Markus-Fitz/Simple_amp_discrete_Rev-A/images/render_PSU.PNG

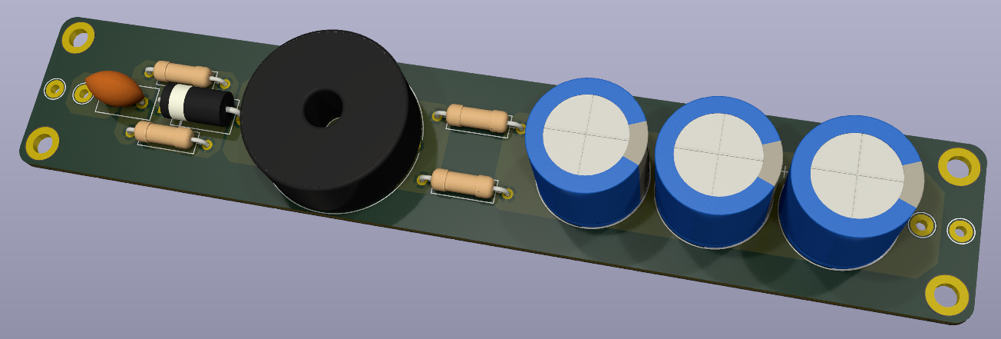
images/render_PSU.PNG
