Markus-Fitz/Simple_amp_discrete_Rev-A/images/rendering.PNG

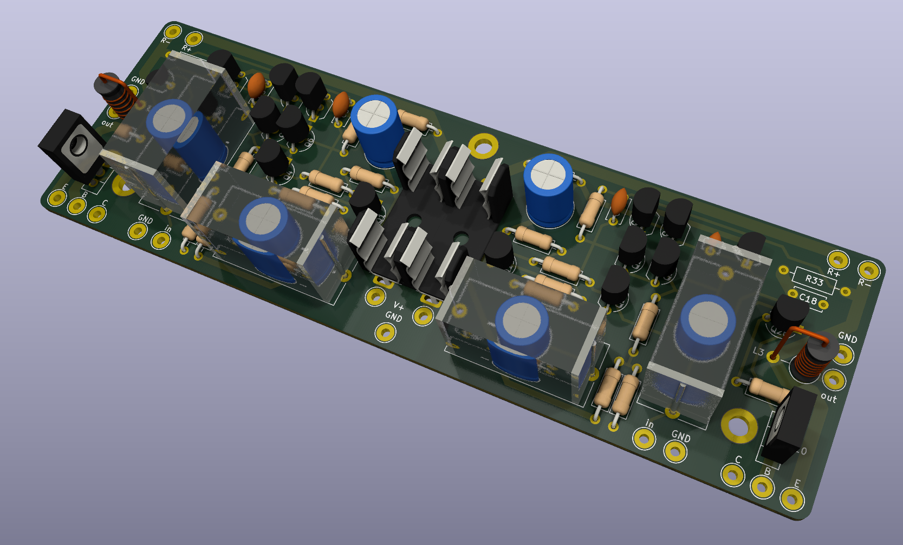
images/rendering.PNG
