Markus-Fitz/Simple_amp_discrete_Rev-A/images/bode_plot.PNG

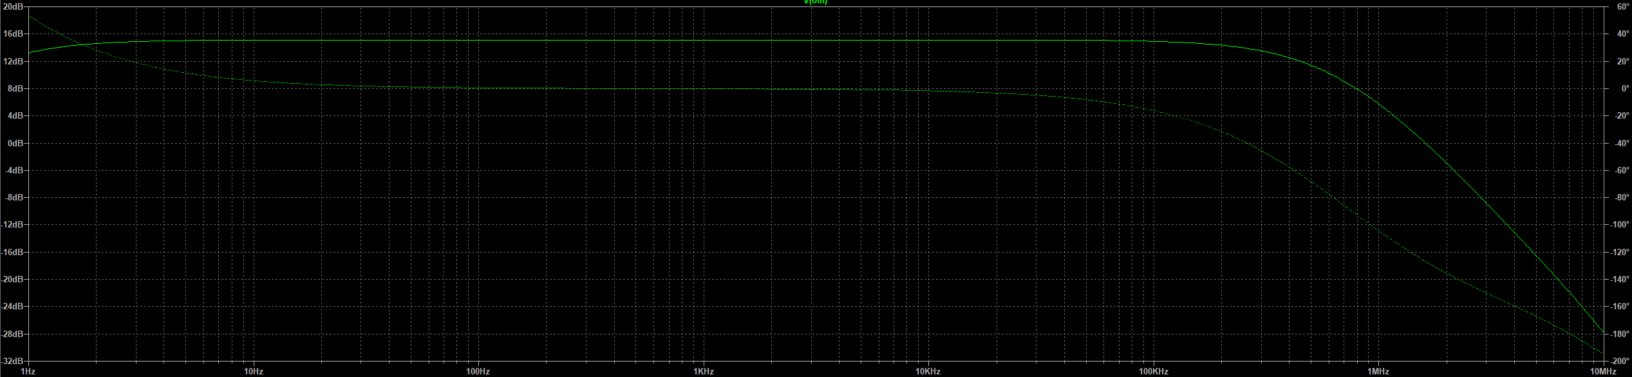
images/bode_plot.PNG
