Markus-Fitz/Simple_amp_discrete_Rev-A/images/bode_plot_fully_transistorized.PNG

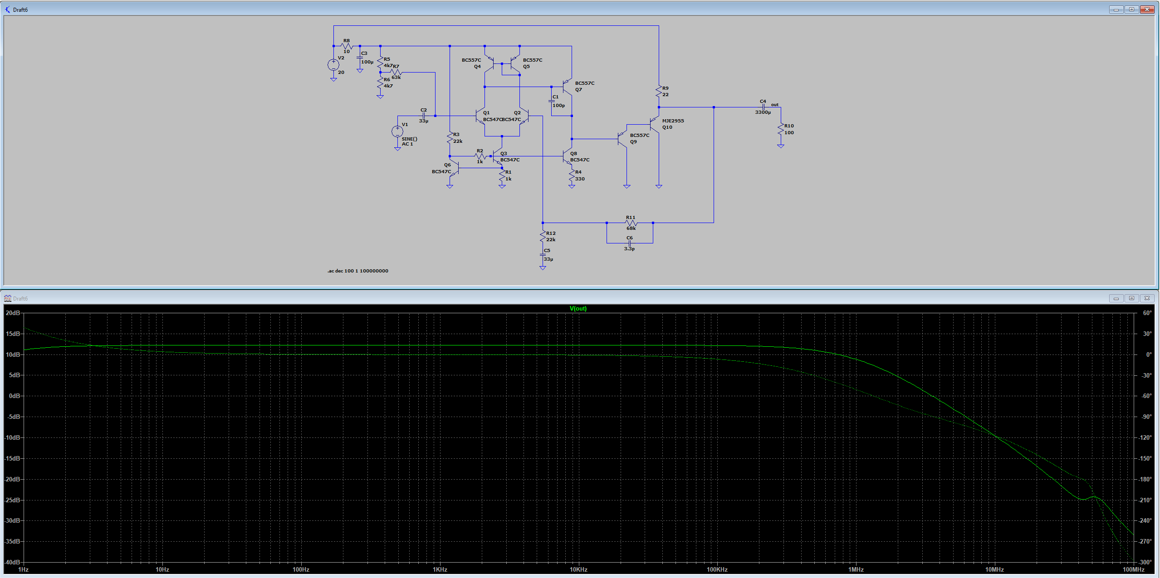
images/bode_plot_fully_transistorized.PNG
