Markus-Fitz/Simple_amp_discrete_Rev-A/images/PCB.PNG

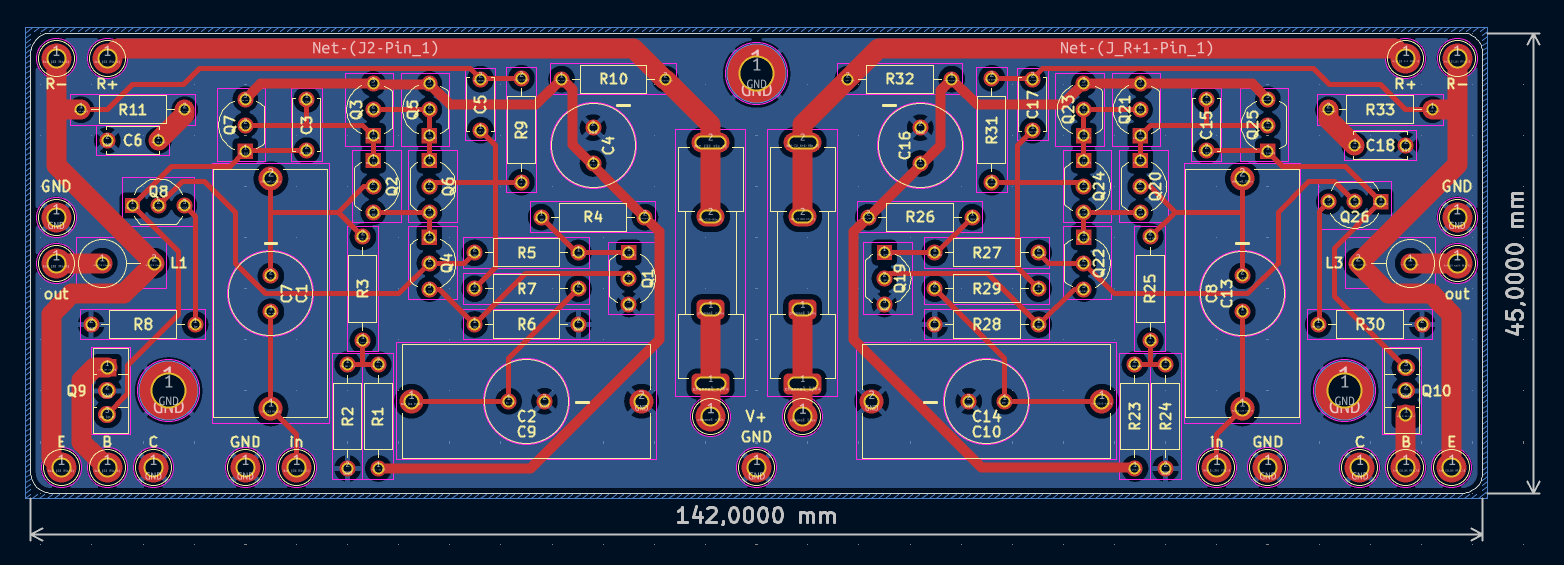
images/PCB.PNG
