Markus-Fitz/Simple_amp_discrete_Rev-A/images/PCB_back.PNG

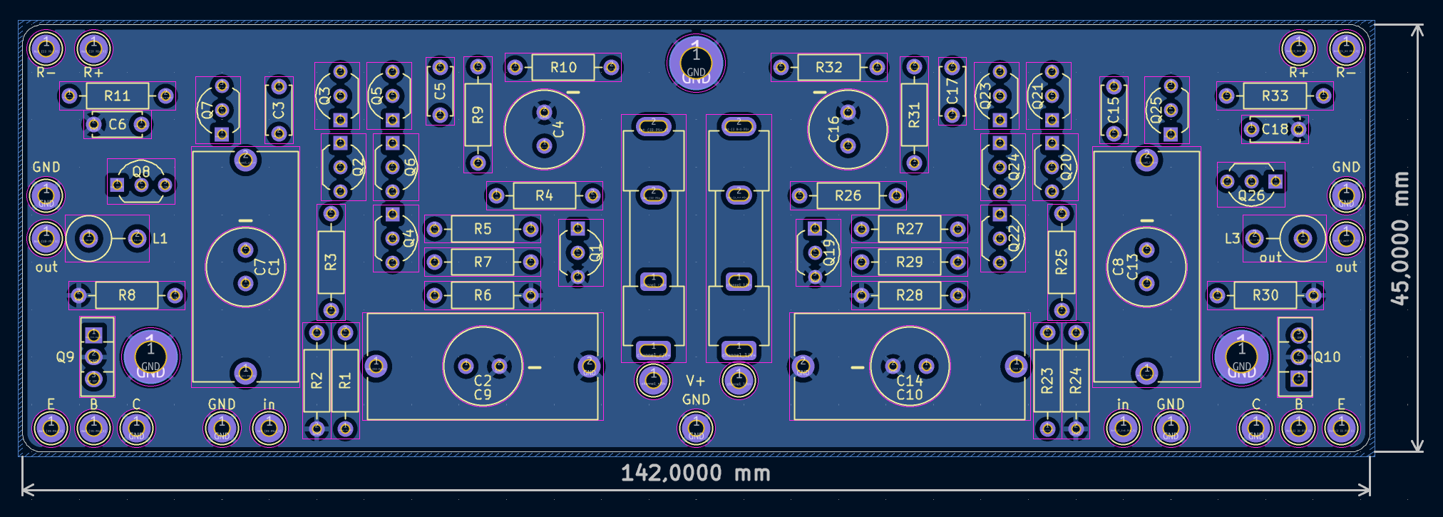
images/PCB_back.PNG
