Markus-Fitz/Simple_amp_discrete_Rev-A/images/PCB_delay-board.png

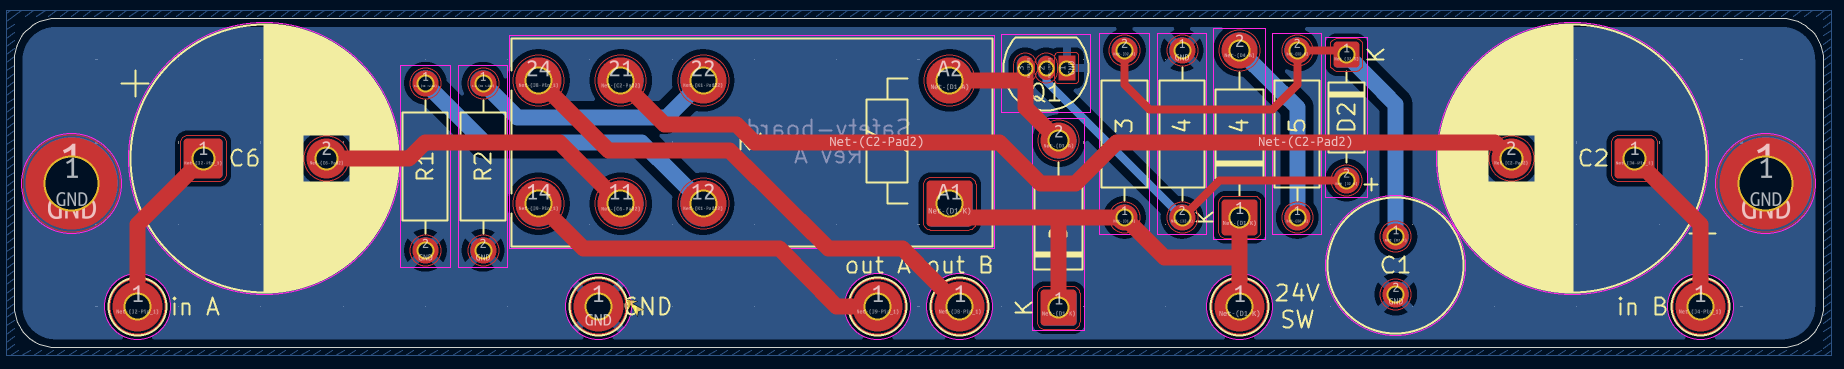
images/PCB_delay-board.png
