Markus-Fitz/Simple_amp_discrete_Rev-A/images/PCB_front.PNG

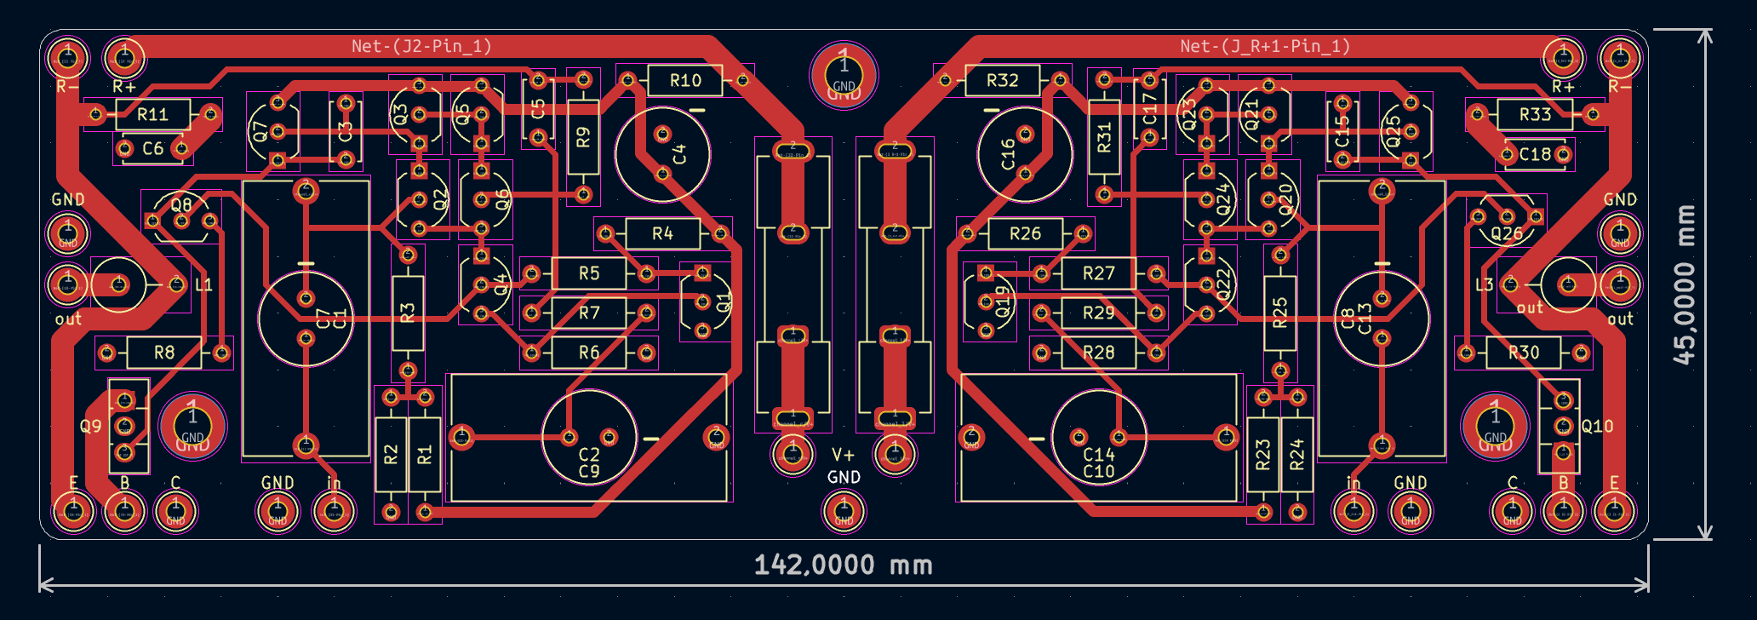
images/PCB_front.PNG
