Markus-Fitz/Simple_amp_discrete_Rev-A/images/PCB_PSU_front.PNG

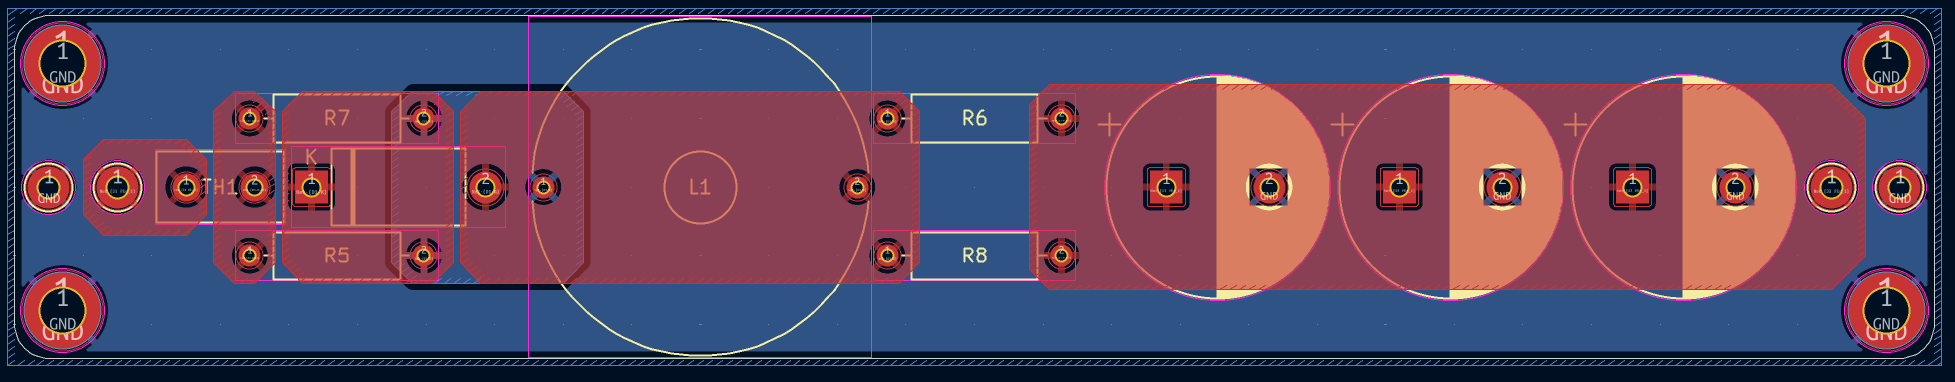
images/PCB_PSU_front.PNG
