Markus-Fitz/Simple_amp_discrete_Rev-A/images/rendering_delay-board.png

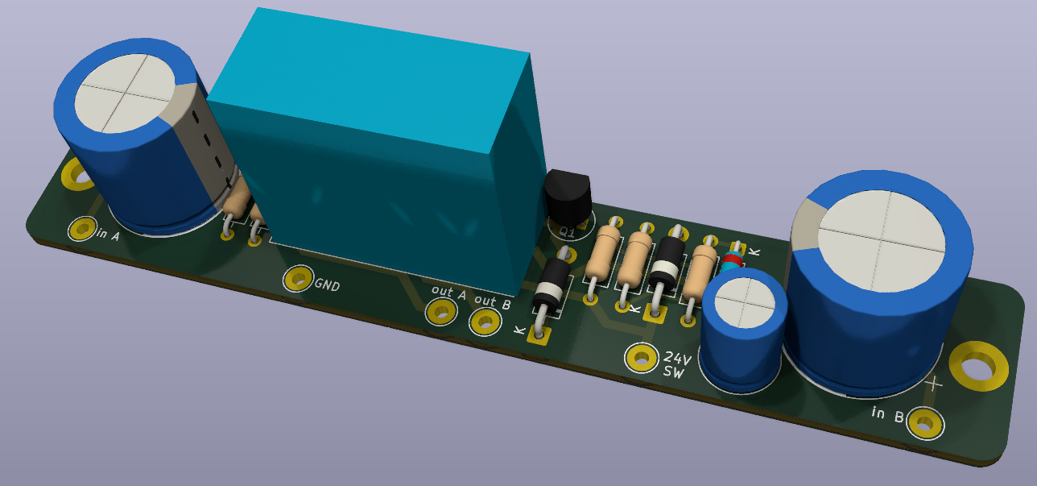
images/rendering_delay-board.png
