Markus-Fitz/Simple_amp_discrete_Rev-A/images/schematic.PNG

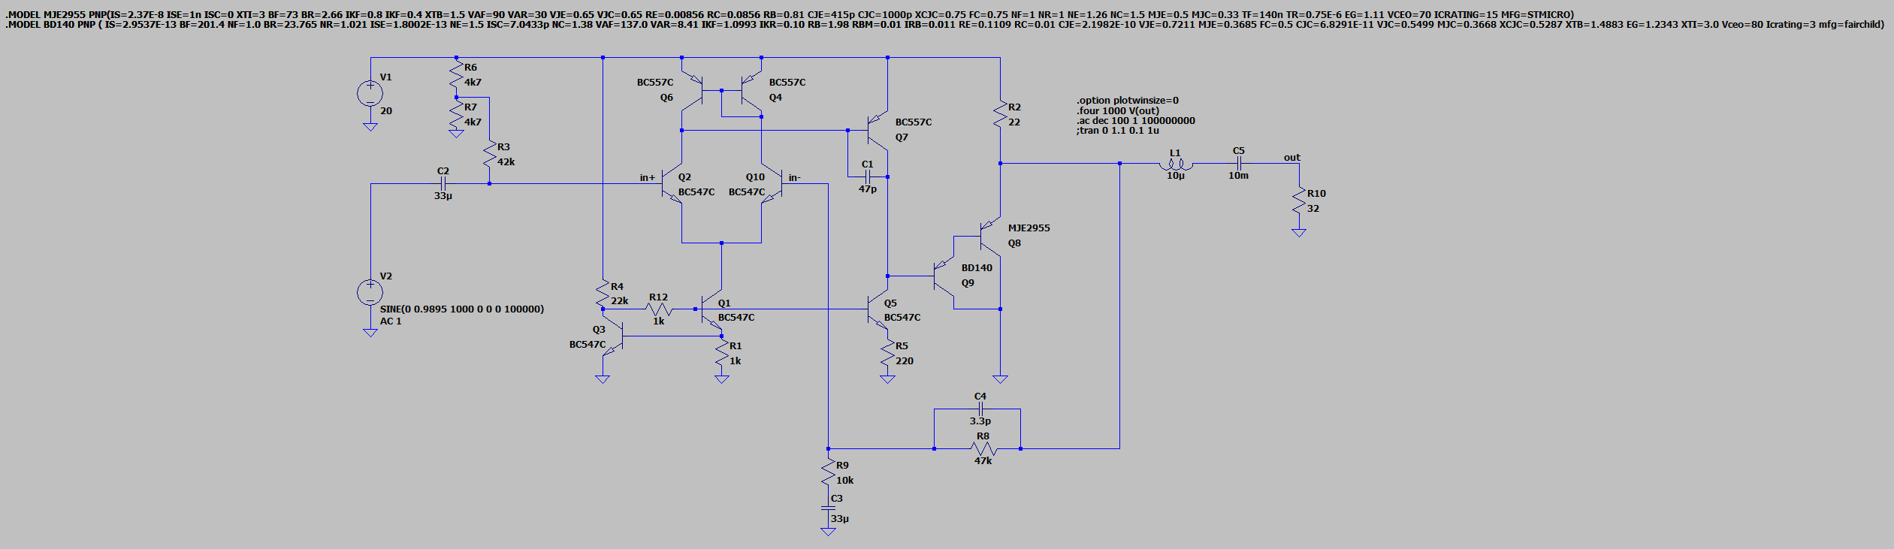
images/schematic.PNG
