Markus-Fitz/Simple_amp_discrete_Rev-A/images/schematic_delay-board.png

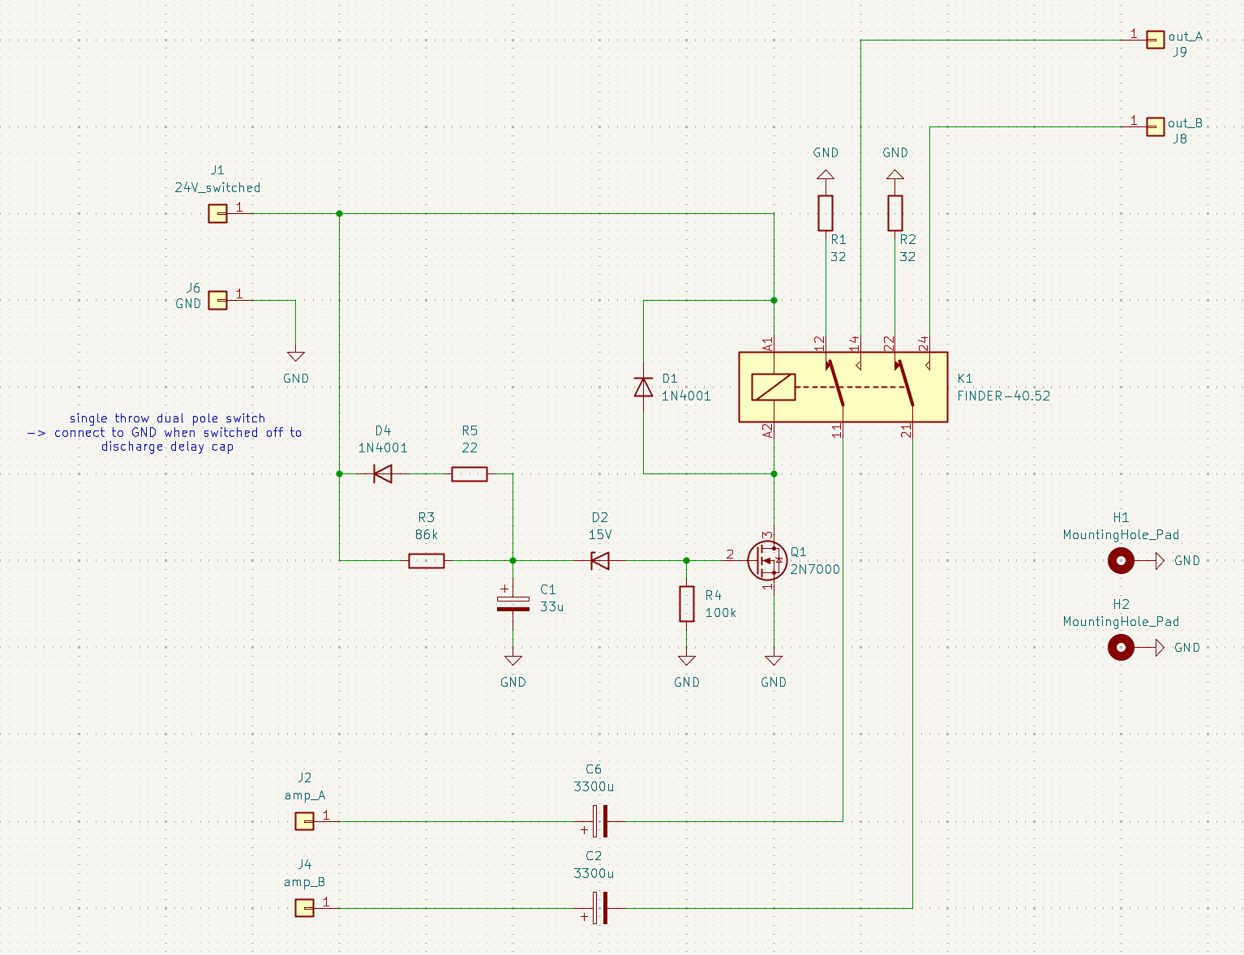
images/schematic_delay-board.png
