Markus-Fitz/Simple_amp_discrete_Rev-A/images/Schematic_high-level.PNG

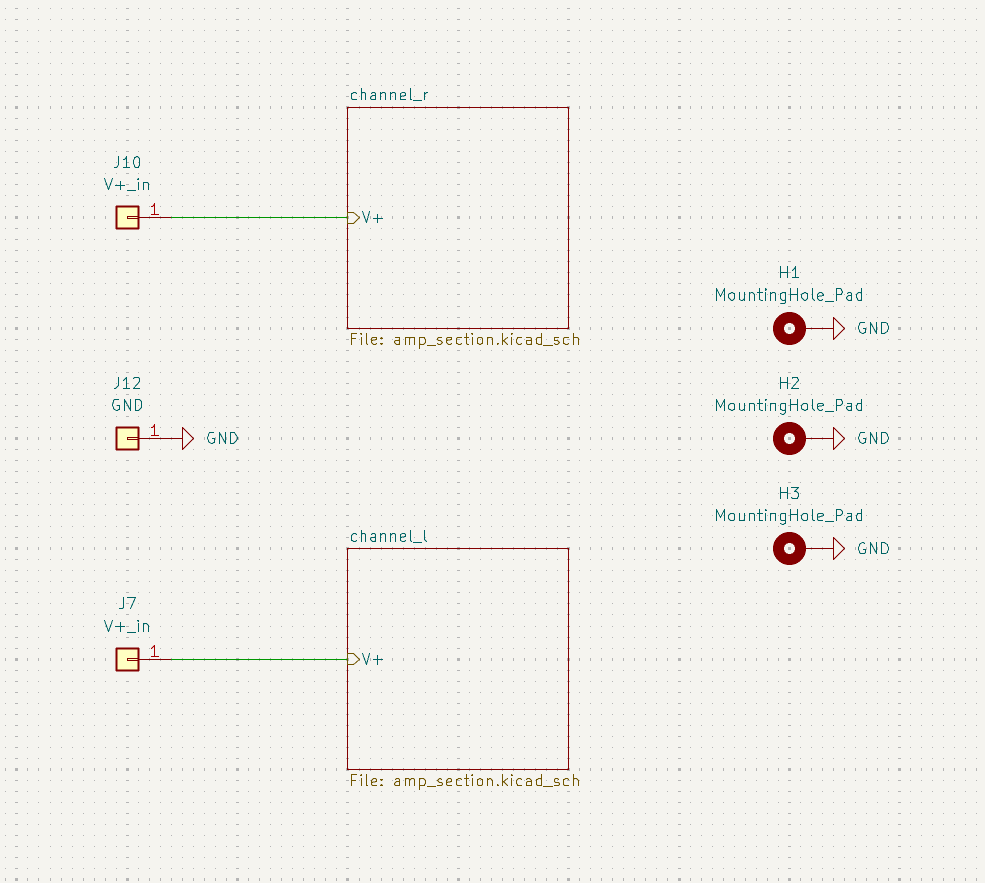
images/Schematic_high-level.PNG
