Markus-Fitz/Simple_amp_discrete_Rev-A/images/schematic_PSU.PNG

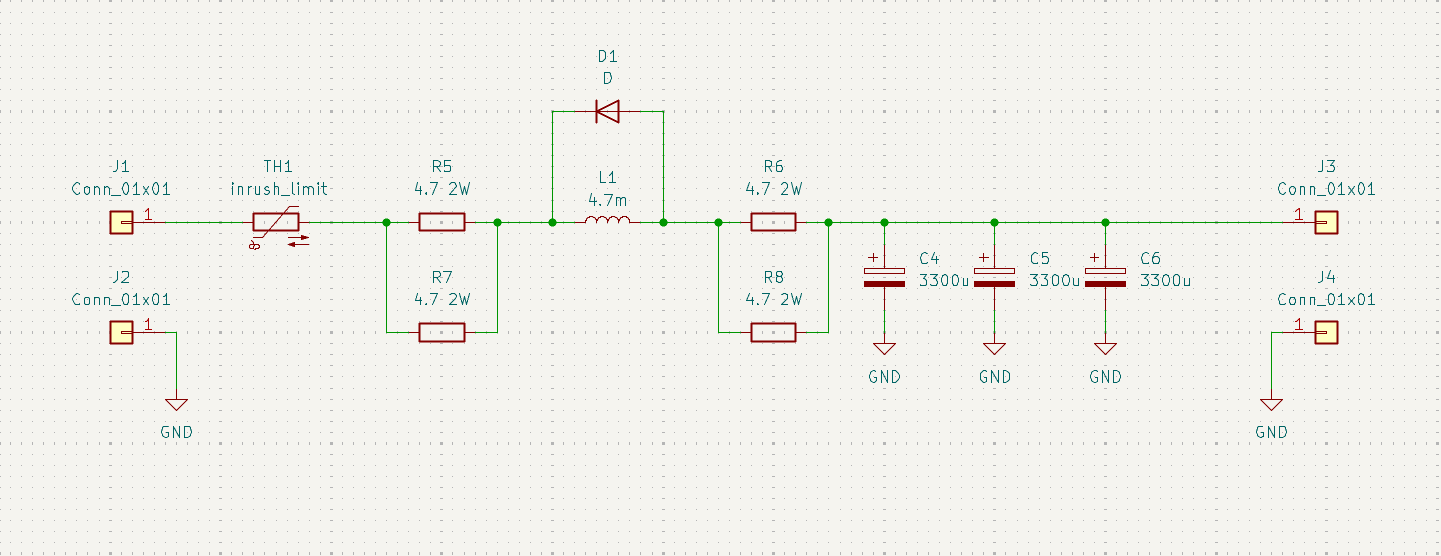
images/schematic_PSU.PNG
