Markus-Fitz/Simple_amp_discrete_Rev-A/images/Schematic_single-channel.PNG

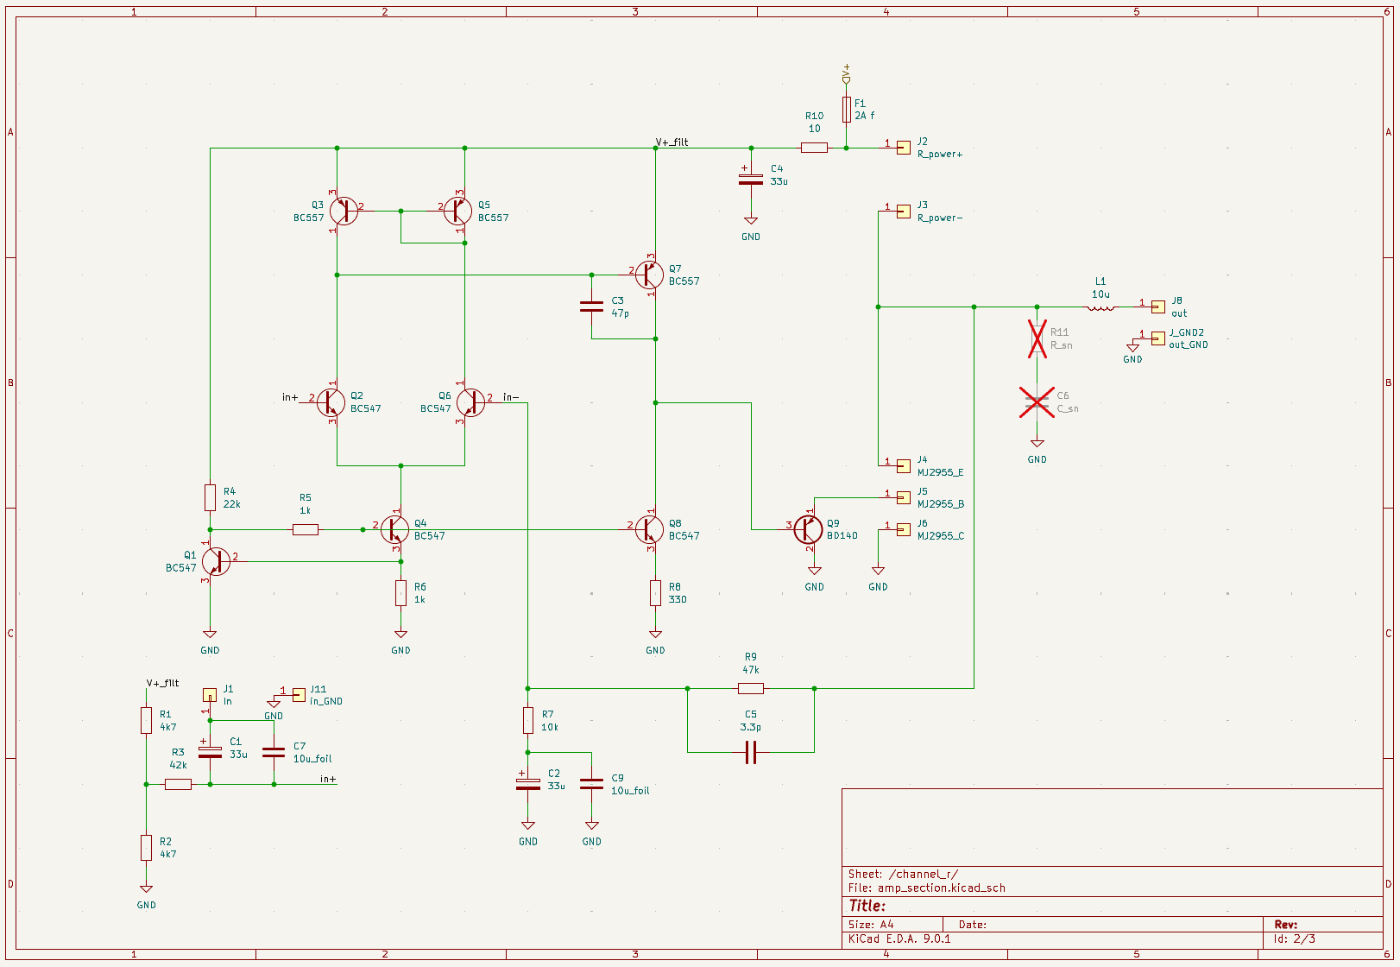
images/Schematic_single-channel.PNG
