Markus-Fitz/Simple_amp_discrete_Rev-A/amp_board_Rev-A/mechanical data/amp_board_Rev-A.step

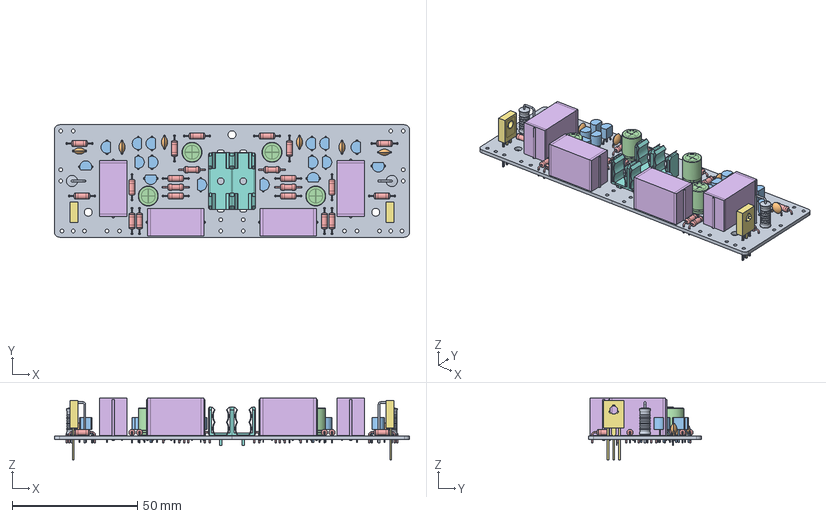
[picture p17: CAD file, 2025-06-10]
amp_board_Rev-A/mechanical data/amp_board_Rev-A.step
142.0 x 45.0 x 24.8 mm
L_Axial_L11.0mm_D4.5mm_P5.08mm_Vertical_Fastron_MECC x 2
C_Disc_D5.0mm_W2.5mm_P5.00mm x 6
TO-92_Inline_Wide x 16
C_Radial_D8.0mm_H11.5mm_P3.50mm x 8
R_Axial_DIN0207_L6.3mm_D2.5mm_P10.16mm_Horizontal x 22
C_Rect_L24.0mm_W10.9mm_P22.50mm_MKT x 4
TO-126-3_Vertical x 2
Fuseholder_Cylinder-5x20mm_Schurter_0031_8201_Horizontal_Open x 2
amp_board_Rev-A_PCB
