Markus-Fitz/Simple_amp_discrete_Rev-A/passive_PSU_Rev-A/mechanical data/passive_PSU_Rev-A.step

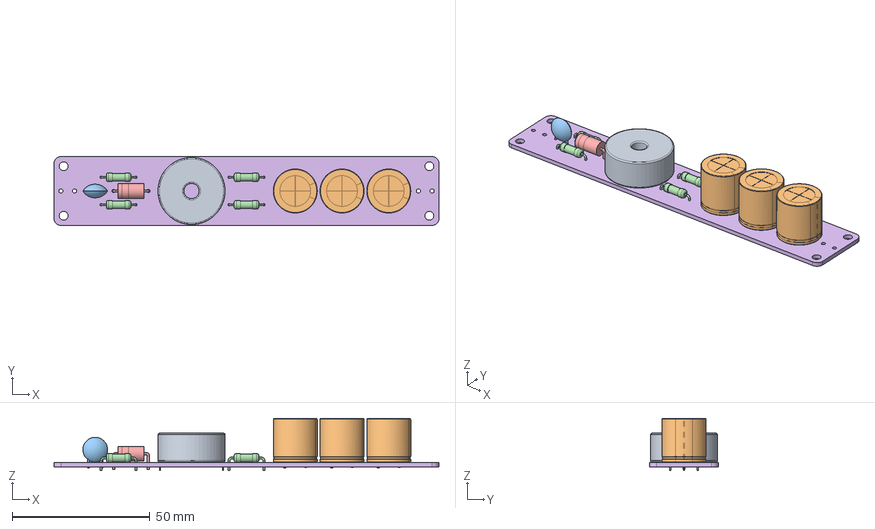
[picture p18: CAD file, 2025-06-10]
passive_PSU_Rev-A/mechanical data/passive_PSU_Rev-A.step
140.0 x 25.0 x 19.0 mm
L_Radial_D24.4mm_P22.90mm_Murata_1400series
CP_Radial_D16.0mm_P7.50mm x 3
C_Disc_D9.0mm_W5.0mm_P5.00mm
R_Axial_DIN0309_L9.0mm_D3.2mm_P12.70mm_Horizontal x 4
D_DO-27_P12.70mm_Horizontal
passive_PSU_Rev-A_PCB
