Markus-Fitz/Simple_amp_discrete_Rev-A/safety_board_Rev-A/mechanical data/safety_board_Rev-A.step

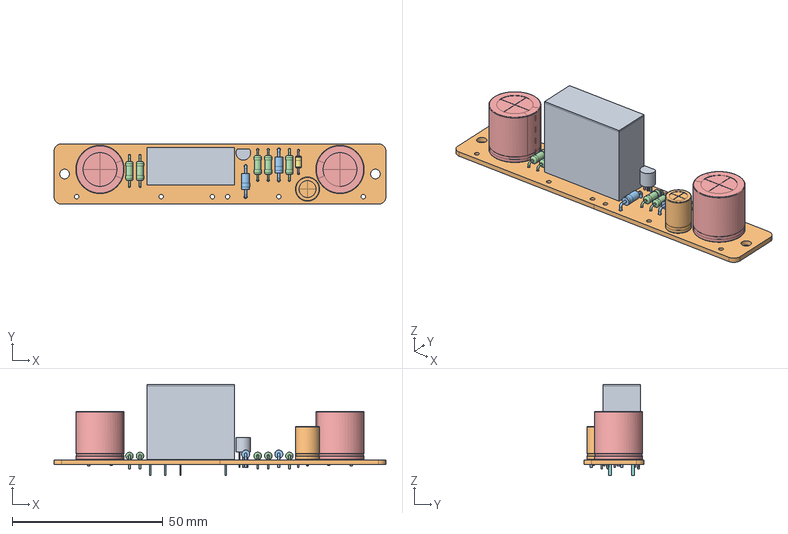
[picture p19: CAD file, 2025-06-10]
safety_board_Rev-A/mechanical data/safety_board_Rev-A.step
110.0 x 20.0 x 30.3 mm
TO-92_Inline
C_Radial_D8.0mm_H11.5mm_P3.50mm
D_DO-41_SOD81_P10.16mm_Horizontal x 2
R_Axial_DIN0207_L6.3mm_D2.5mm_P10.16mm_Horizontal x 5
CP_Radial_D16.0mm_P7.50mm x 2
D_DO-35_SOD27_P7.62mm_Horizontal
Relay_DPDT_Finder_40.52
safety_board_Rev-A_PCB
