Markus-Fitz/Simple_amp_discrete_Rev-A/safety_board_Rev-A/safety_board_Rev-A.kicad_pcb

## KiCad design safety_board_Rev-A/safety_board_Rev-A.kicad_pcb (2025-06-14)

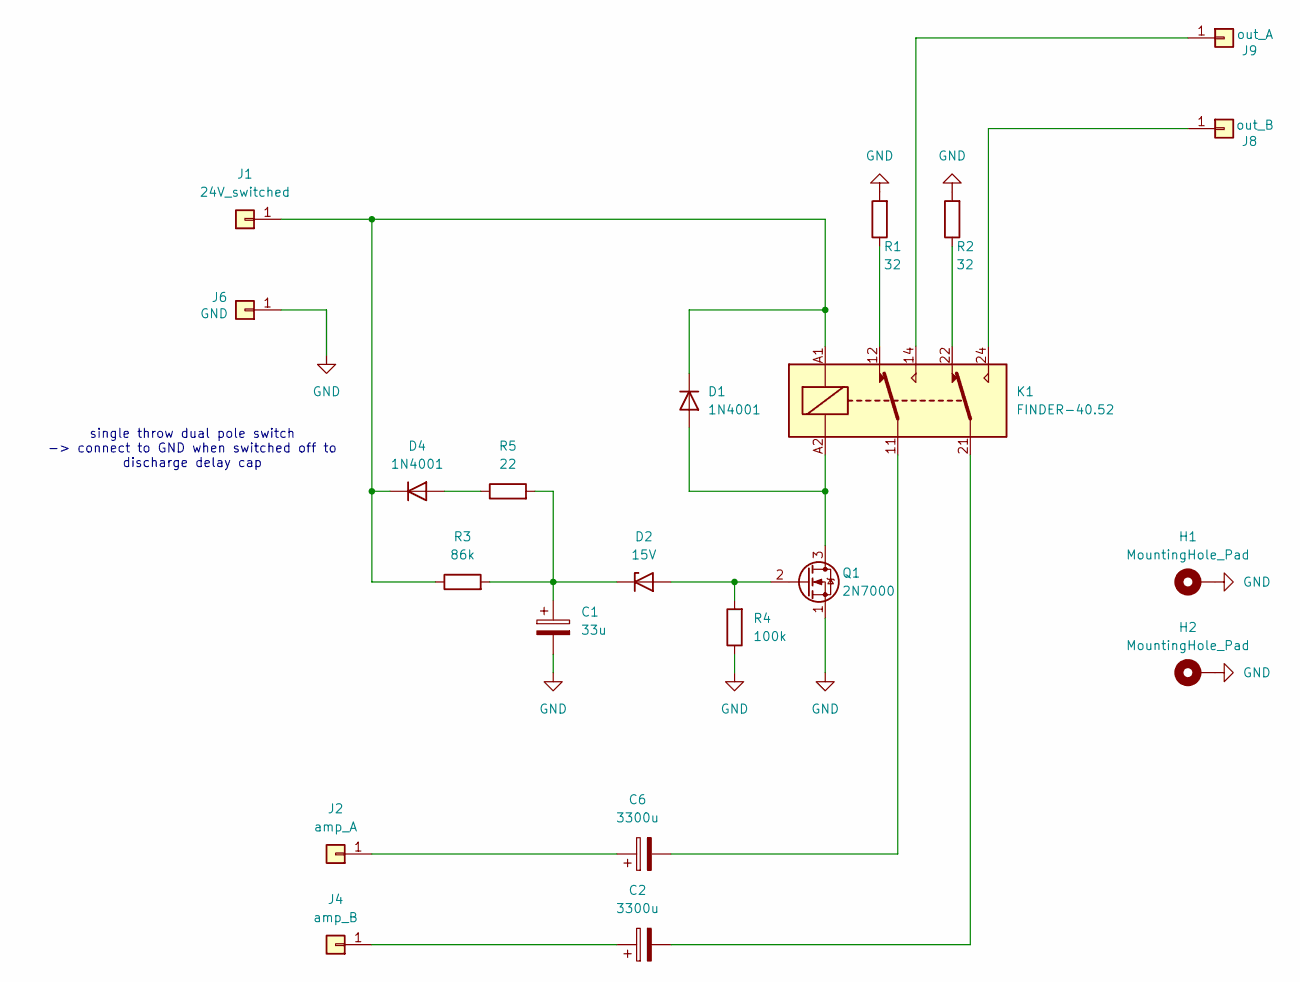
[picture p20: schematic safety_board_Rev-A.kicad_sch]

Parts:
C1: 33u; C_Radial_D8.0mm_H11.5mm_P3.50mm
C2, C6: 3300u; CP_Radial_D16.0mm_P7.50mm; MPN UFW1V332MHD
D1, D4: 1N4001; D_DO-41_SOD81_P10.16mm_Horizontal
D2: 15V; D_DO-35_SOD27_P7.62mm_Horizontal
H1, H2: MountingHole_Pad; MountingHole_3.2mm_M3_DIN965_Pad_TopBottom
J1: 24V_switched; TestPoint_THTPad_D3.0mm_Drill1.5mm
J2: amp_A; TestPoint_THTPad_D3.0mm_Drill1.5mm
J4: amp_B; TestPoint_THTPad_D3.0mm_Drill1.5mm
J6: GND; TestPoint_THTPad_D3.0mm_Drill1.5mm
J8: out_B; TestPoint_THTPad_D3.0mm_Drill1.5mm
J9: out_A; TestPoint_THTPad_D3.0mm_Drill1.5mm
K1: FINDER-40.52; Relay_DPDT_Finder_40.52
Q1: 2N7000; TO-92_Inline
R1, R2: 32; R_Axial_DIN0207_L6.3mm_D2.5mm_P10.16mm_Horizontal
R3: 86k; R_Axial_DIN0207_L6.3mm_D2.5mm_P10.16mm_Horizontal
R4: 100k; R_Axial_DIN0207_L6.3mm_D2.5mm_P10.16mm_Horizontal
R5: 22; R_Axial_DIN0207_L6.3mm_D2.5mm_P10.16mm_Horizontal

Connections:
GND: C1.2, H1.1, H2.1, J6.1, Q1.1 (S), R1.2, R2.2, R4.1
unnamed: C2.2, K1.21
unnamed: C6.2, K1.11
unnamed: D1.2 (A), K1.A2, Q1.3 (D)
unnamed: D1.1 (K), D4.1 (K), J1.1, K1.A1, R3.1
unnamed: D2.2 (A), Q1.2 (G), R4.2
unnamed: C1.1, D2.1 (K), R3.2, R5.2
unnamed: D4.2 (A), R5.1
unnamed: C6.1, J2.1
unnamed: C2.1, J4.1
unnamed: J8.1, K1.24
unnamed: J9.1, K1.14
unnamed: K1.12, R1.1
unnamed: K1.22, R2.1

Notes on the sheet:
single throw dual pole switch -> connect to GND when switched off to discharge delay cap

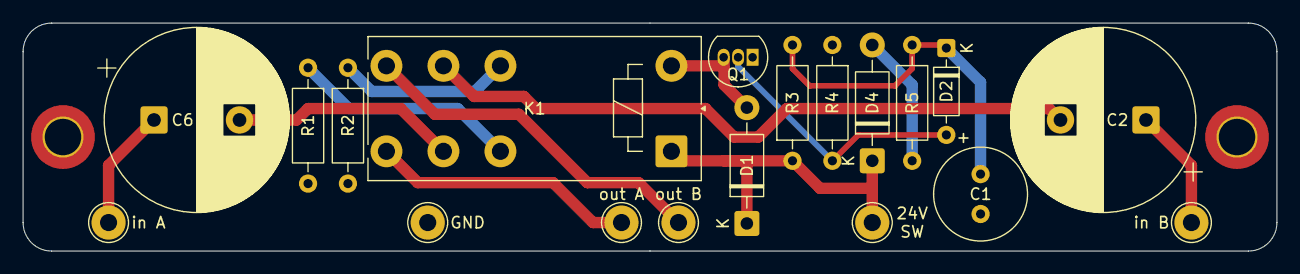
[picture p21: board safety_board_Rev-A.kicad_pcb from above]

Board: 2 copper layers, 110.0 x 20.0 mm, 21 parts (0 on the bottom side), 14 nets.
