Markus-Fitz/Simple_amp_discrete_Rev-A/amp_board_Rev-A/amp_board_Rev-A.kicad_pcb

## KiCad design amp_board_Rev-A/amp_board_Rev-A.kicad_pcb (2025-06-10)

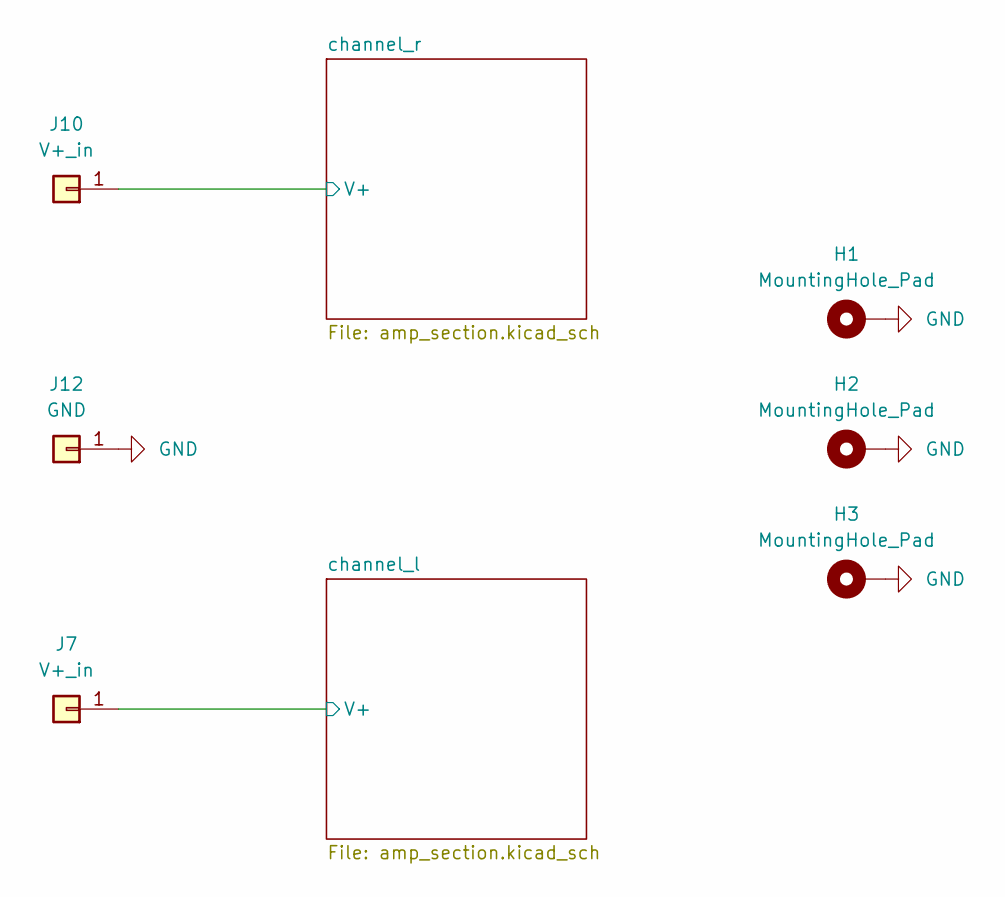
[picture p22: schematic amp_board_Rev-A.kicad_sch]

Parts:
H1, H2, H3: MountingHole_Pad; MountingHole_3.2mm_M3_DIN965_Pad_TopBottom
J7, J10: V+_in; TestPoint_THTPad_D3.0mm_Drill1.5mm
J12: GND; TestPoint_THTPad_D3.0mm_Drill1.5mm

Connections:
/channel_l/V+: J7.1; also elsewhere on the board
/channel_r/V+: J10.1; also elsewhere on the board
GND: H1.1, H2.1, H3.1, J12.1; also elsewhere on the board

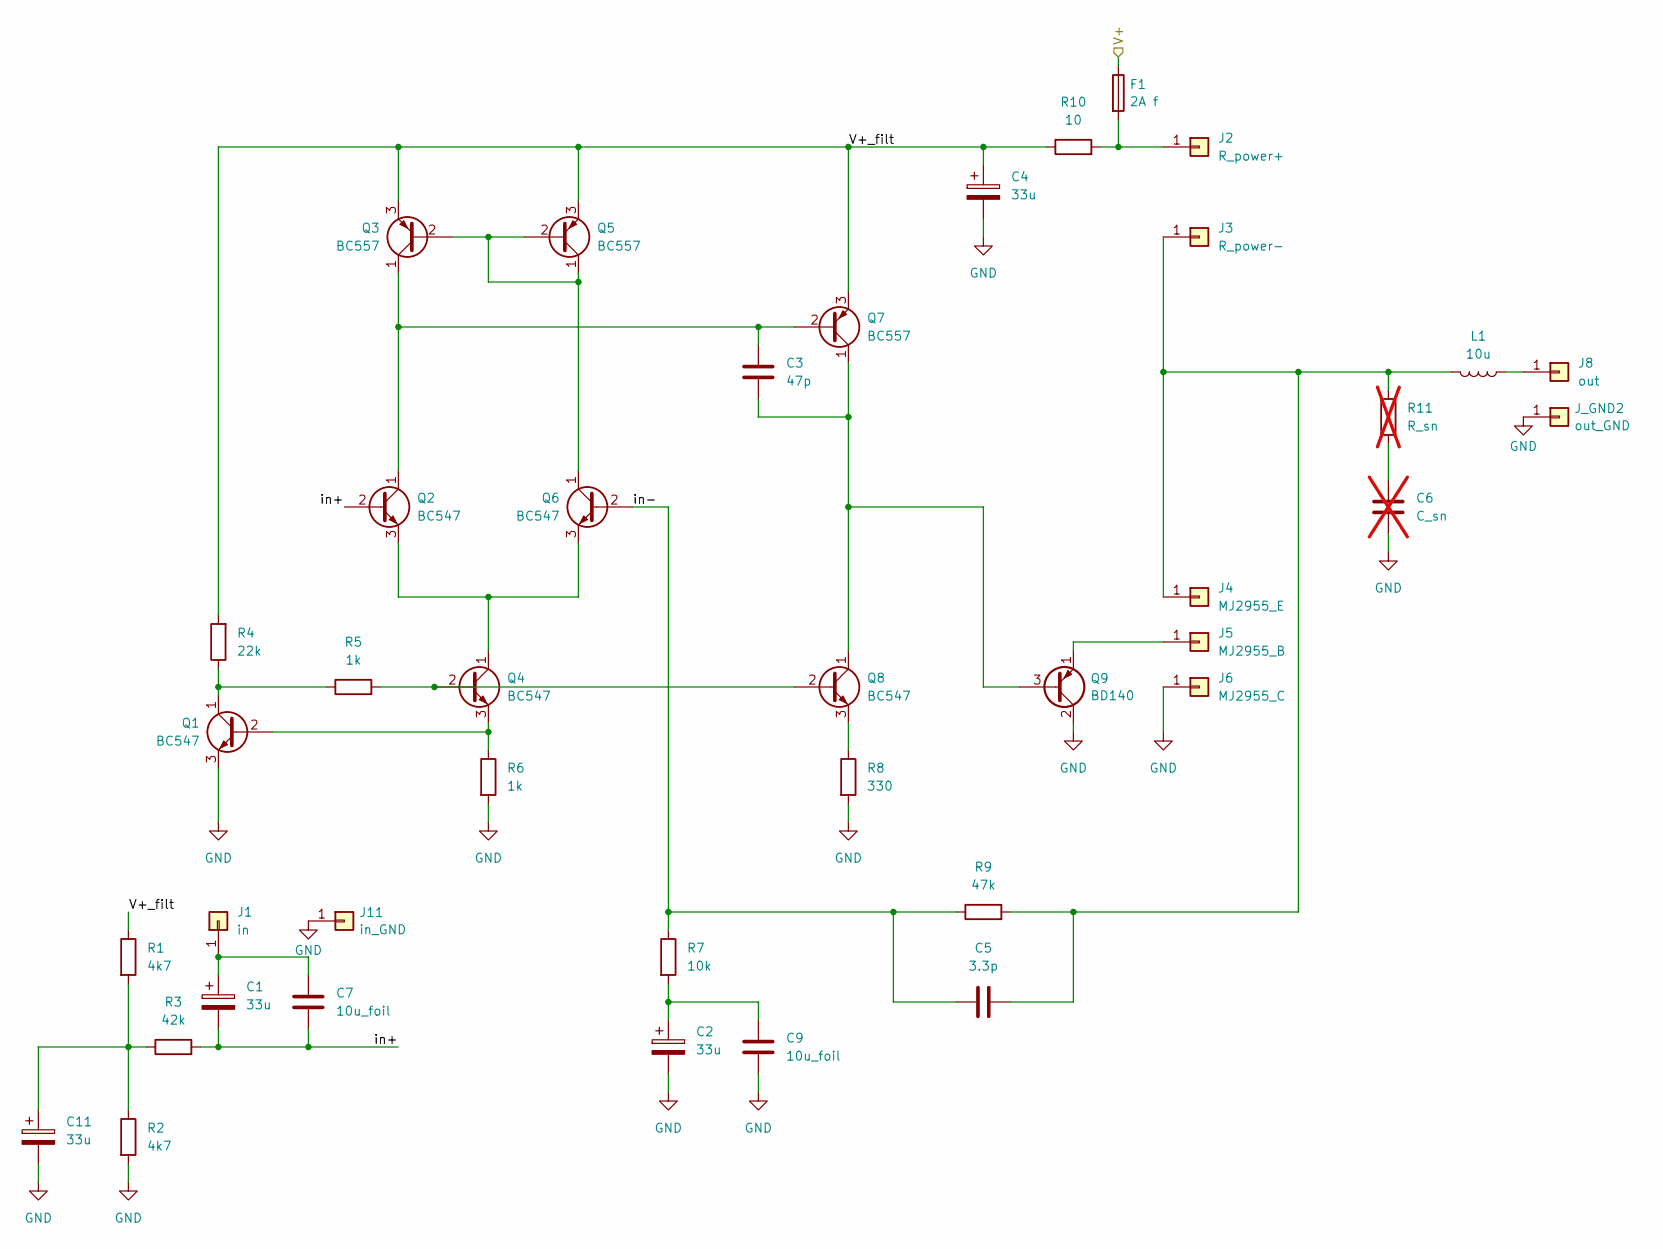
[picture p23: schematic amp_section.kicad_sch]

Parts:
C1, C2, C4, C11: 33u; C_Radial_D8.0mm_H11.5mm_P3.50mm
C3: 47p; C_Disc_D5.0mm_W2.5mm_P5.00mm
C5: 3.3p; C_Disc_D5.0mm_W2.5mm_P5.00mm
C6: C_sn; C_Disc_D5.0mm_W2.5mm_P5.00mm; not fitted
C7, C9: 10u_foil; C_Rect_L24.0mm_W10.9mm_P22.50mm_MKT
F1: 2A f; Fuseholder_Clip-5x20mm_Keystone_3512P_Inline_P23.62x7.27mm_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
J1: in; TestPoint_THTPad_D3.0mm_Drill1.5mm
J2: R_power+; TestPoint_THTPad_D3.0mm_Drill1.5mm
J3: R_power-; TestPoint_THTPad_D3.0mm_Drill1.5mm
J4: MJ2955_E; TestPoint_THTPad_D3.0mm_Drill1.5mm
J5: MJ2955_B; TestPoint_THTPad_D3.0mm_Drill1.5mm
J6: MJ2955_C; TestPoint_THTPad_D3.0mm_Drill1.5mm
J8: out; TestPoint_THTPad_D3.0mm_Drill1.5mm
J11: in_GND; TestPoint_THTPad_D3.0mm_Drill1.5mm
J_GND2: out_GND; TestPoint_THTPad_D3.0mm_Drill1.5mm
L1: 10u; L_Axial_L11.0mm_D4.5mm_P5.08mm_Vertical_Fastron_MECC
Q1, Q2, Q4, Q6, Q8: BC547; TO-92_Inline_Wide
Q3, Q5, Q7: BC557; TO-92_Inline_Wide
Q9: BD140; TO-126-3_Vertical
R1, R2: 4k7; R_Axial_DIN0207_L6.3mm_D2.5mm_P10.16mm_Horizontal
R3: 42k; R_Axial_DIN0207_L6.3mm_D2.5mm_P10.16mm_Horizontal
R4: 22k; R_Axial_DIN0207_L6.3mm_D2.5mm_P10.16mm_Horizontal
R5, R6: 1k; R_Axial_DIN0207_L6.3mm_D2.5mm_P10.16mm_Horizontal
R7: 10k; R_Axial_DIN0207_L6.3mm_D2.5mm_P10.16mm_Horizontal
R8: 330; R_Axial_DIN0207_L6.3mm_D2.5mm_P10.16mm_Horizontal
R9: 47k; R_Axial_DIN0207_L6.3mm_D2.5mm_P10.16mm_Horizontal
R10: 10; R_Axial_DIN0207_L6.3mm_D2.5mm_P10.16mm_Horizontal
R11: R_sn; R_Axial_DIN0207_L6.3mm_D2.5mm_P10.16mm_Horizontal; not fitted

Connections:
/channel_r/V+: F1.1; also elsewhere on the board
/channel_r/V+_filt: C4.1, Q3.3 (E), Q5.3 (E), Q7.3 (E), R1.1, R4.2, R10.1
/channel_r/in+: C1.2, C7.2, Q2.2 (B), R3.2
/channel_r/in-: C5.1, Q6.2 (B), R7.1, R9.1
GND: C2.2, C4.2, C6.2, C9.2, C11.2, J6.1, J11.1, J_GND2.1, Q1.3 (E), Q9.2 (C), R2.2, R6.2, R8.2; also elsewhere on the board
unnamed: C2.1, C9.1, R7.2
unnamed: C6.1, R11.2
unnamed: C11.1, R1.2, R2.1, R3.1
unnamed: C1.1, C7.1, J1.1
unnamed: F1.2, J2.1, R10.2
unnamed: C5.2, J3.1, J4.1, L1.2, R9.2, R11.1
unnamed: J5.1, Q9.1 (E)
unnamed: J8.1, L1.1
unnamed: Q1.2 (B), Q4.3 (E), R6.1
unnamed: Q1.1 (C), R4.1, R5.1
unnamed: C3.1, Q2.1 (C), Q3.1 (C), Q7.2 (B)
unnamed: Q2.3 (E), Q4.1 (C), Q6.3 (E)
unnamed: Q3.2 (B), Q5.1 (C), Q5.2 (B), Q6.1 (C)
unnamed: Q4.2 (B), Q8.2 (B), R5.2
unnamed: C3.2, Q7.1 (C), Q8.1 (C), Q9.3 (B)
unnamed: Q8.3 (E), R8.1

Parts of its further copies:
C8, C10: 10u_foil; C_Rect_L24.0mm_W10.9mm_P22.50mm_MKT
C12, C13, C14, C16: 33u; C_Radial_D8.0mm_H11.5mm_P3.50mm
C15: 47p; C_Disc_D5.0mm_W2.5mm_P5.00mm
C17: 3.3p; C_Disc_D5.0mm_W2.5mm_P5.00mm
C18: C_sn; C_Disc_D5.0mm_W2.5mm_P5.00mm; not fitted
F2: 2A f; Fuseholder_Clip-5x20mm_Keystone_3512P_Inline_P23.62x7.27mm_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
J_B1: MJ2955_B; TestPoint_THTPad_D3.0mm_Drill1.5mm
J_C1: MJ2955_C; TestPoint_THTPad_D3.0mm_Drill1.5mm
J_E1: MJ2955_E; TestPoint_THTPad_D3.0mm_Drill1.5mm
J_GND1: in_GND; TestPoint_THTPad_D3.0mm_Drill1.5mm
J_GND3: out_GND; TestPoint_THTPad_D3.0mm_Drill1.5mm
J_R+1: R_power+; TestPoint_THTPad_D3.0mm_Drill1.5mm
J_R-1: R_power-; TestPoint_THTPad_D3.0mm_Drill1.5mm
J_in1: in; TestPoint_THTPad_D3.0mm_Drill1.5mm
J_out1: out; TestPoint_THTPad_D3.0mm_Drill1.5mm
L3: 10u; L_Axial_L11.0mm_D4.5mm_P5.08mm_Vertical_Fastron_MECC
Q10: BD140; TO-126-3_Vertical
Q19, Q20, Q22, Q24, Q26: BC547; TO-92_Inline_Wide
Q21, Q23, Q25: BC557; TO-92_Inline_Wide
R23, R24: 4k7; R_Axial_DIN0207_L6.3mm_D2.5mm_P10.16mm_Horizontal
R25: 42k; R_Axial_DIN0207_L6.3mm_D2.5mm_P10.16mm_Horizontal
R26: 22k; R_Axial_DIN0207_L6.3mm_D2.5mm_P10.16mm_Horizontal
R27, R28: 1k; R_Axial_DIN0207_L6.3mm_D2.5mm_P10.16mm_Horizontal
R29: 10k; R_Axial_DIN0207_L6.3mm_D2.5mm_P10.16mm_Horizontal
R30: 330; R_Axial_DIN0207_L6.3mm_D2.5mm_P10.16mm_Horizontal
R31: 47k; R_Axial_DIN0207_L6.3mm_D2.5mm_P10.16mm_Horizontal
R32: 10; R_Axial_DIN0207_L6.3mm_D2.5mm_P10.16mm_Horizontal
R33: R_sn; R_Axial_DIN0207_L6.3mm_D2.5mm_P10.16mm_Horizontal; not fitted

Connections of its further copies:
/channel_l/V+: F2.1; also elsewhere on the board
/channel_l/V+_filt: C16.1, Q21.3 (E), Q23.3 (E), Q25.3 (E), R23.1, R26.2, R32.1
/channel_l/in+: C8.2, C13.2, Q20.2 (B), R25.2
/channel_l/in-: C17.1, Q24.2 (B), R29.1, R31.1
GND: C10.2, C12.2, C14.2, C16.2, C18.2, J_C1.1, J_GND1.1, J_GND3.1, Q10.2 (C), Q19.3 (E), R24.2, R28.2, R30.2; also elsewhere on the board
unnamed: C10.1, C14.1, R29.2
unnamed: C12.1, R23.2, R24.1, R25.1
unnamed: C18.1, R33.2
unnamed: J_B1.1, Q10.1 (E)
unnamed: C17.2, J_E1.1, J_R-1.1, L3.2, R31.2, R33.1
unnamed: F2.2, J_R+1.1, R32.2
unnamed: C8.1, C13.1, J_in1.1
unnamed: J_out1.1, L3.1
unnamed: C15.2, Q10.3 (B), Q25.1 (C), Q26.1 (C)
unnamed: Q19.2 (B), Q22.3 (E), R28.1
unnamed: Q19.1 (C), R26.1, R27.1
unnamed: C15.1, Q20.1 (C), Q21.1 (C), Q25.2 (B)
unnamed: Q20.3 (E), Q22.1 (C), Q24.3 (E)
unnamed: Q21.2 (B), Q23.1 (C), Q23.2 (B), Q24.1 (C)
unnamed: Q22.2 (B), Q26.2 (B), R27.2
unnamed: Q26.3 (E), R30.1

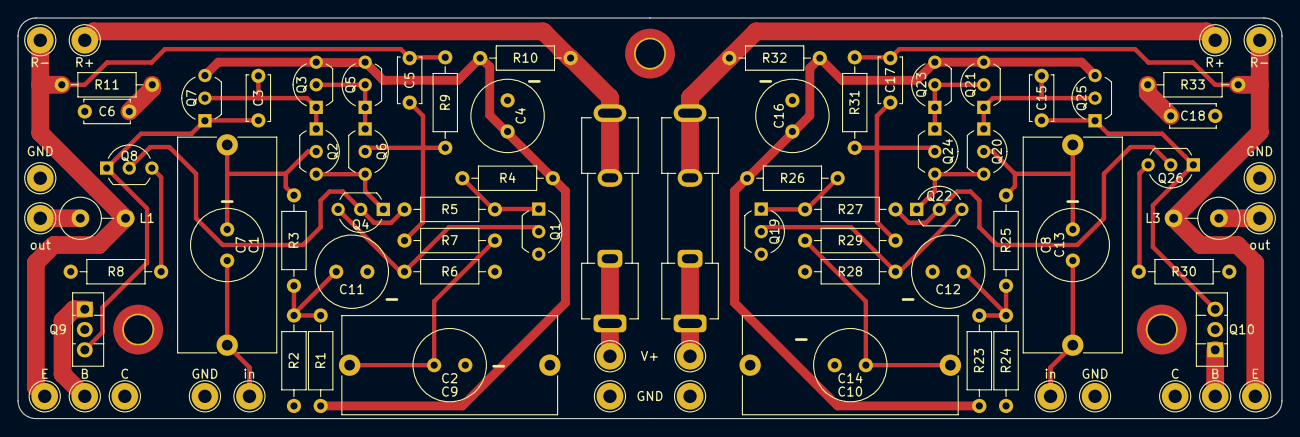
[picture p24: board amp_board_Rev-A.kicad_pcb from above]

Board: 2 copper layers, 142.0 x 45.0 mm, 87 parts (0 on the bottom side), 41 nets.

Other parts of the board:
J9: GND; TestPoint_THTPad_D3.0mm_Drill1.5mm

Their connections:
GND: J9.1; also elsewhere on the board
