Markus-Fitz/Simple_amp_discrete_Rev-A/passive_PSU_Rev-A/passive_PSU_Rev-A.kicad_pcb

## KiCad design passive_PSU_Rev-A/passive_PSU_Rev-A.kicad_pcb (2025-06-10)

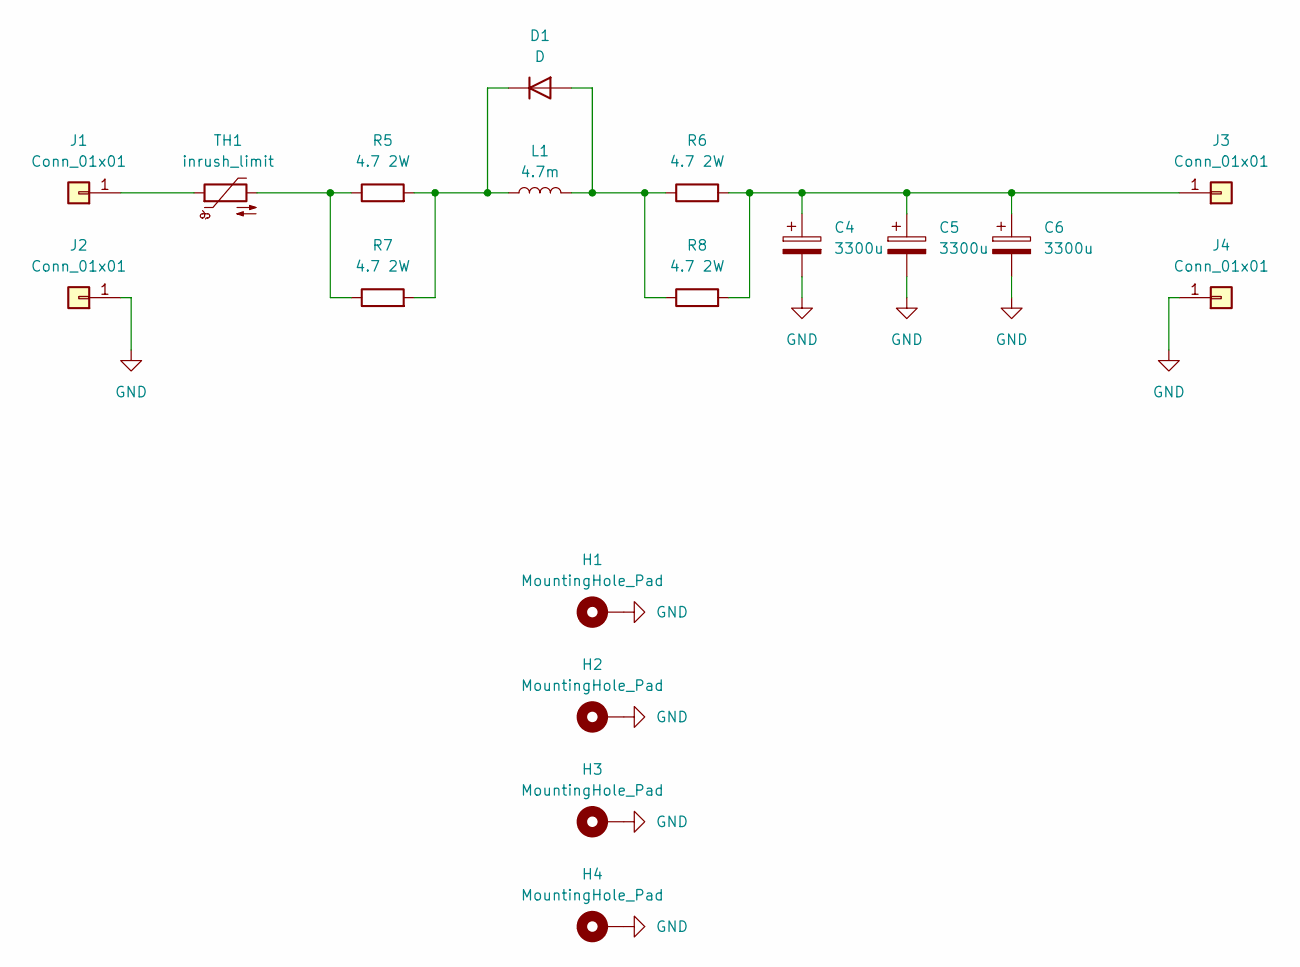
[picture p25: schematic passive_PSU_Rev-A.kicad_sch]

Parts:
C4, C5, C6: 3300u; CP_Radial_D16.0mm_P7.50mm; MPN UFW1V332MHD
D1: D; D_DO-27_P12.70mm_Horizontal
H1, H2, H3, H4: MountingHole_Pad; MountingHole_3.2mm_M3_DIN965_Pad_TopBottom
J1, J2, J3, J4: Conn_01x01; TestPoint_THTPad_D3.0mm_Drill1.5mm
L1: 4.7m; L_Radial_D24.4mm_P22.90mm_Murata_1400series
R5, R6, R7, R8: 4.7 2W; R_Axial_DIN0309_L9.0mm_D3.2mm_P12.70mm_Horizontal; MPN WA83ZI-4R7JT06
TH1: inrush_limit; C_Disc_D9.0mm_W5.0mm_P5.00mm; MPN B57153S0100M054

Connections:
GND: C4.2, C5.2, C6.2, H1.1, H2.1, H3.1, H4.1, J2.1, J4.1
unnamed: D1.2 (A), L1.2, R6.1, R8.1
unnamed: D1.1 (K), L1.1, R5.2, R7.2
unnamed: J1.1, TH1.1
unnamed: C4.1, C5.1, C6.1, J3.1, R6.2, R8.2
unnamed: R5.1, R7.1, TH1.2

Board: 2 copper layers, 18 parts (0 on the bottom side), 6 nets, no tracks yet.
