Markus-Fitz/Simple_amp_discrete_Rev-A/(commit log)

2025-06-10 Added local files.
    [amp_board_Rev-A-B_Cu.gbl, amp_board_Rev-A-B_Mask.gbs, amp_board_Rev-A-B_Paste.gbp, amp_board_Rev-A-B_Silkscreen.gbo, amp_board_Rev-A-Edge_Cuts.gm1, amp_board_Rev-A-F_Cu.gtl, amp_board_Rev-A-F_Mask.gts, amp_board_Rev-A-F_Paste.gtp]
2025-06-14 Added images for the turn-on delay board, visual modifications to schematic.
    [safety_board_Rev-A.kicad_pcb, safety_board_Rev-A.kicad_sch]
